apex737/Turret/reports/step8/v2_report.md

# Step8 v2 — Salford 밖 FPV 양성 추가 (CNN14 임베딩 + 로지스틱 회귀, 기체 하나씩 빼는 5-fold)

> `Tools/ml/train_v2.py`가 만든 파일. 새 FPV(DVIDS 영상 사람 라벨, Freesound 2개)는 학습 전용이고 시험 데이터는 v0과 같다.
> 문턱: 학습 데이터 안 교차검증에서 비드론 창 오탐 1%. 사건·클립 판정은 연속 3창 중 2창.

| 설정 | FPV 창 재현율 | FPV 창 AUC | FPV 대 곤충 AUC | Matrice 통과 AUC | Air 3(WS) 재현율 | 평균 창 AUC | 사건 (2-of-3) | 오탐/시간 | 장치 경로 재현율 (FPV / Mini3 / Air3) |
| --- | --- | --- | --- | --- | --- | --- | --- | --- | --- |
| v0 | 0.17 | 0.912 | 0.53 | 0.502 | 0.12 | 0.893 | 19/21 | 10.3 | 0.01 / 0.23 / 0.42 |
| v2 | 0.43 | 0.956 | 0.75 | 0.446 | 0.16 | 0.897 | 17/21 | 10.0 | 0.13 / 0.34 / 0.46 |
| v2m | 0.35 | 0.944 | 0.77 | 0.579 | 0.17 | 0.905 | 18/21 | 9.2 | 0.16 / 0.29 / 0.45 |
| v2m+N | 0.33 | 0.938 | 0.83 | 0.636 | 0.24 | 0.915 | 17/21 | 5.4 | 0.07 / 0.16 / 0.55 |
| v2m+dev | 0.34 | 0.948 | 0.78 | 0.567 | 0.16 | 0.902 | 17/21 | 7.3 | 0.13 / 0.19 / 0.21 |

**출처 사이 일반화:** DVIDS를 빼고 학습한 모델(fold 1 조건 + Freesound FPV)의 DVIDS FPV 창 재현율: dvids_110920176 0.19 (16창), dvids_111069165 0.54 (69창), dvids_24meu 0.46 (605창), dvids_26meu 0.00 (20창), dvids_predator26 0.48 (29창)

## v2 fold별

| fold | 시험 기체 | 창 AUC | 창 재현율 | 창 오탐률 | 사건 | 비드론 클립 오탐 | 장치 경로 재현율 |
| --- | --- | --- | --- | --- | --- | --- | --- |
| 1 | DJI FPV | 0.956 | 0.43 | 0.014 | 3/3 | 8/400 | 0.13 |
| 2 | Mini 3 Pro | 0.980 | 0.76 | 0.008 | 6/6 | 4/398 | 0.34 |
| 3 | Matrice 300 | 0.699 | 0.16 | 0.009 | 2/6 | 2/398 | - |
| 4 | Yuneec H520E | 0.990 | 0.84 | 0.010 | 4/4 | 6/398 | - |
| 5 | Air 3 (WS) | 0.862 | 0.16 | 0.009 | 2/2 | 6/397 | 0.46 |

v2 오탐이 많은 비드론 범주 (클립 수): insects 4, vacuum_cleaner 3, chirping_birds 2, washing_machine 2, airplane 2, chainsaw 2, door_wood_creaks 2, can_opening 1, rain 1, car_horn 1
