apex737/Turret/reports/step8/v1_report.md

# Step8 v1 — 증강 + 장치 잡음 음성 (CNN14 임베딩 + 로지스틱 회귀, 기체 하나씩 빼는 5-fold)

> `Tools/ml/train_v1.py`가 만든 파일. 입력 `embed_v0.py`(원본), `embed_v1.py`(증강·장치). 모델·fold·문턱 규칙은 v0과 같다.
> 문턱: 학습 데이터 안 교차검증에서 비드론 창 오탐 1%. 사건·클립 판정은 연속 3창 중 2창. 시험 fold는 증강하지 않는다.

## 설정별 요약

| 설정 | FPV 창 재현율 | Matrice 통과 AUC | Matrice 통과 재현율 | Air 3(WS) 재현율 | 평균 창 AUC | 사건 (2-of-3) | 오탐/시간 | 장치 경로 재현율 (FPV / Mini3 / Air3) |
| --- | --- | --- | --- | --- | --- | --- | --- | --- |
| v0 | 0.17 | 0.502 | 0.05 | 0.12 | 0.893 | 19/21 | 10.3 | 0.01 / 0.23 / 0.42 |
| +S | 0.19 | 0.492 | 0.05 | 0.12 | 0.893 | 19/21 | 10.7 | 0.01 / 0.19 / 0.37 |
| +D | 0.18 | 0.495 | 0.05 | 0.13 | 0.892 | 19/21 | 9.2 | 0.01 / 0.23 / 0.39 |
| +E | 0.19 | 0.490 | 0.05 | 0.12 | 0.888 | 19/21 | 11.5 | 0.01 / 0.25 / 0.40 |
| +N | 0.24 | 0.620 | 0.03 | 0.21 | 0.903 | 17/21 | 7.7 | 0.01 / 0.18 / 0.55 |
| +A | 0.06 | 0.673 | 0.06 | 0.15 | 0.886 | 17/21 | 5.0 | 0.00 / 0.12 / 0.41 |
| +dev | 0.18 | 0.473 | 0.05 | 0.11 | 0.887 | 18/21 | 8.8 | 0.01 / 0.17 / 0.29 |
| v1 | 0.07 | 0.639 | 0.03 | 0.03 | 0.893 | 17/21 | 1.9 | 0.00 / 0.02 / 0.04 |

**v1 판정 (개발용):** FPV 창 재현율 0.17 → 0.07 (목표 ≥ 0.5), Matrice 통과 AUC 0.502 → 0.639 (목표 ≥ 0.9), 오탐/시간 10.3 → 1.9 (v0 이하) → **미달**

## v1 fold별

| fold | 시험 기체 | 창 AUC | 창 재현율 | 창 오탐률 | 통과/호버 AUC | 사건 (2-of-3) | 비드론 클립 오탐 | 장치 경로 재현율 (창 수, 점수 중앙값) |
| --- | --- | --- | --- | --- | --- | --- | --- | --- |
| 1 | DJI FPV | 0.853 | 0.07 | 0.002 | 0.853 | 2/3 | 1/400 | 0.00 (576, 0.00) |
| 2 | Mini 3 Pro | 0.982 | 0.50 | 0.003 | 0.978 / 0.991 | 6/6 | 0/398 | 0.02 (192, 0.28) |
| 3 | Matrice 300 | 0.796 | 0.06 | 0.006 | 0.639 / 0.928 | 3/6 | 2/398 | - |
| 4 | Yuneec H520E | 0.984 | 0.60 | 0.003 | 0.983 / 0.986 | 4/4 | 0/398 | - |
| 5 | Air 3 (WS) | 0.848 | 0.03 | 0.005 | 0.848 | 2/2 | 2/397 | 0.04 (192, 0.80) |

v1 오탐이 많은 비드론 범주 (클립 수): siren 2, car_horn 1, airplane 1, clock_alarm 1

장치 경로 시험: speaker_10min (노트북 스피커 → 보드 MIC1), 재생 시작 6.75 s (포락선 상관 0.24). 장치 잡음 음성(같은 방·같은 보드)이 학습에 들어가므로 장치 경로 재현율은 낙관적일 수 있다.
