apex737/Turret/reports/step8/v0_report.md

# Step8 v0 — CNN14 임베딩 + 로지스틱 회귀 (공개 원음, 기체 하나씩 빼는 5-fold)

> `Tools/ml/train_v0.py`가 만든 파일. 입력 `Tools/ml/embed_v0.py` (장치와 같은 FIR·↓4 → 16 kHz → 1 s 창 → CNN14).
> 문턱: 학습 데이터 안 교차검증에서 비드론 창 오탐 1%. 사건·클립 판정은 연속 3창 중 2창.

| fold | 시험 기체 (학습에 없음) | 창 AUC | 무학습 AUC | 창 재현율 | 창 오탐률 | 사건 검출 (2-of-3) | 비드론 클립 오탐 |
| --- | --- | --- | --- | --- | --- | --- | --- |
| 1 | DJI FPV | 0.903 | 0.794 | 0.16 | 0.016 | 3/3 | 10/400 |
| 2 | Mini 3 Pro | 0.983 | 0.729 | 0.81 | 0.010 | 6/6 | 5/398 |
| 3 | Matrice 300 | 0.737 | 0.940 | 0.19 | 0.012 | 4/6 | 5/398 |
| 4 | Yuneec H520E | 0.991 | 0.830 | 0.85 | 0.009 | 4/4 | 4/398 |
| 5 | Air 3 (WS) | 0.840 | 0.737 | 0.13 | 0.006 | 2/2 | 3/397 |

**합계**: 드론 사건 19/21 검출, 비드론 클립 27/1991 오탐.

오탐이 많은 비드론 범주 (5 fold 합, 클립 수): airplane 5, insects 4, vacuum_cleaner 3, chainsaw 3, car_horn 2, chirping_birds 2, can_opening 1, snoring 1, washing_machine 1, rain 1, siren 1, wind 1
