apex737/Turret/Plots/CubeMonitor1.png

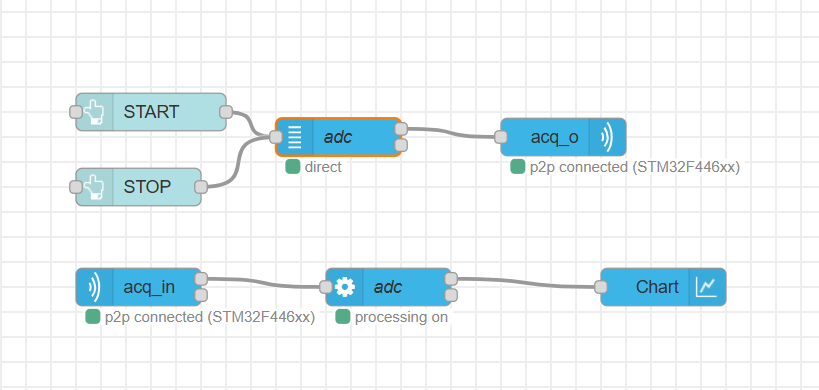
Plots/CubeMonitor1.png
