apex737/Turret/Plots/instruments_v1/preview.png

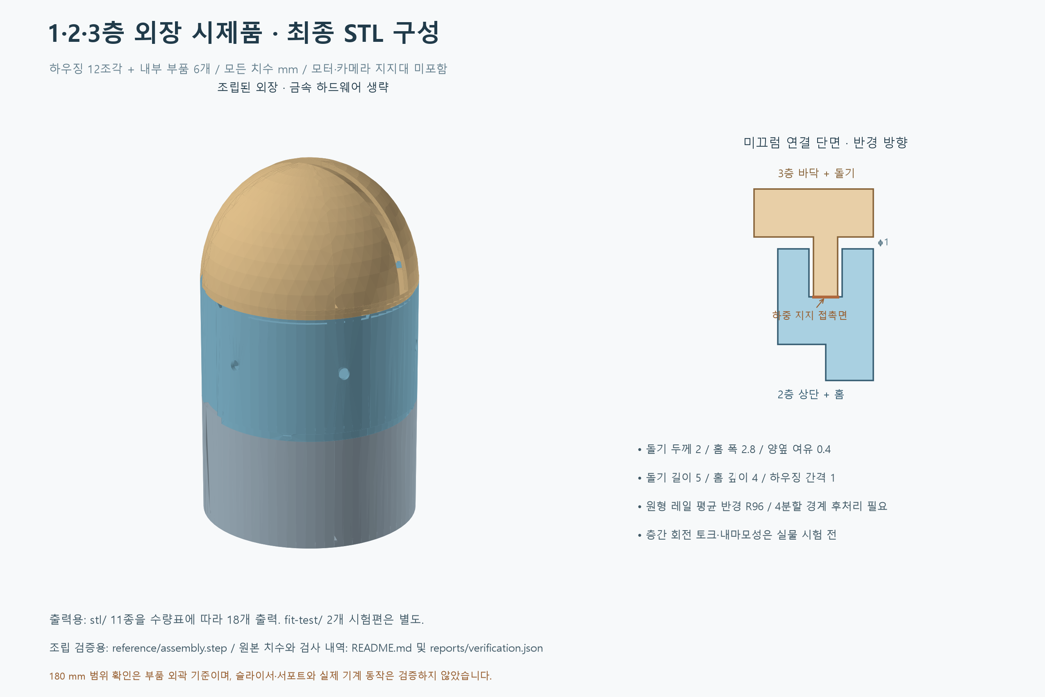
Plots/instruments_v1/preview.png
