apex737/Turret/hardware/enclosure_v1/reference/tier1_assembly.step

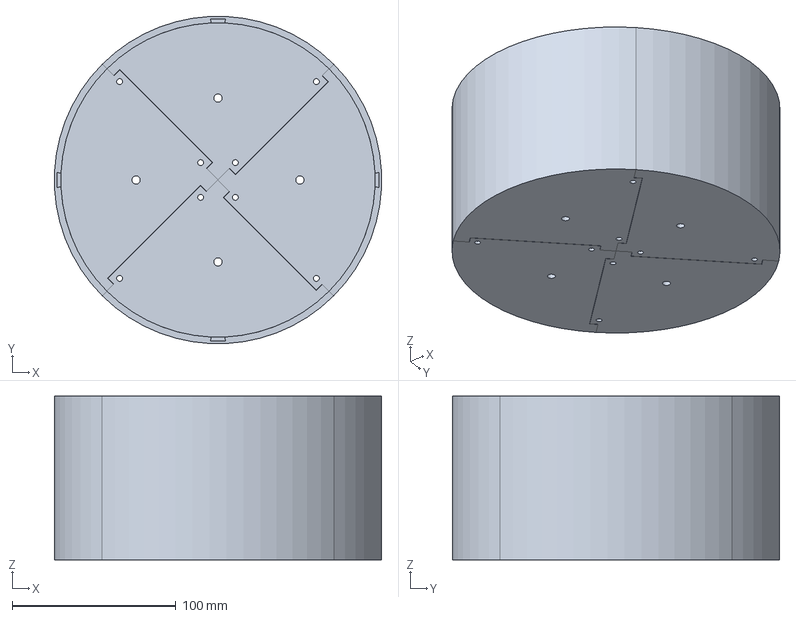
[picture p3: CAD file, 2026-10-22]
hardware/enclosure_v1/reference/tier1_assembly.step
199.7 x 199.7 x 100.0 mm
