apex737/Turret/hardware/enclosure_v1/reference/tier2_assembly.step

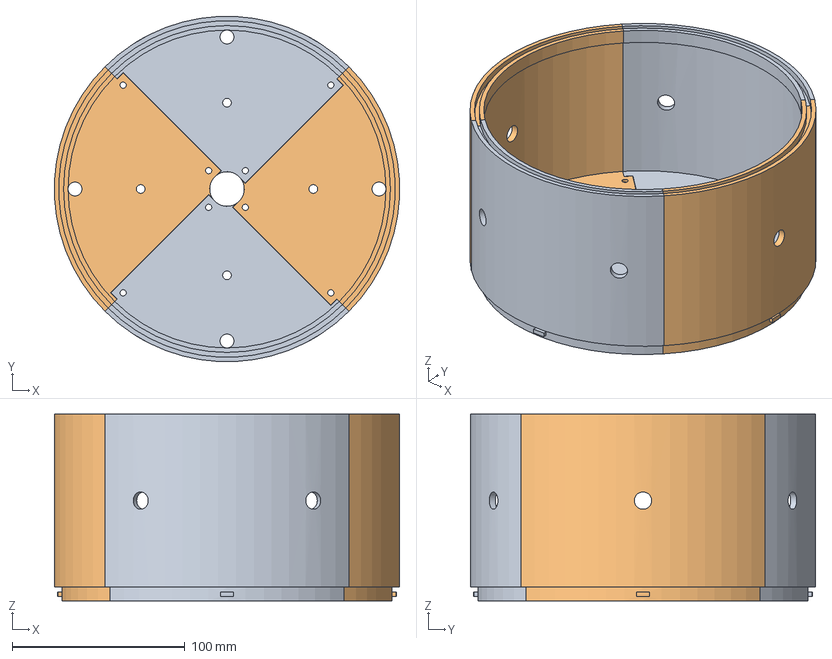
[picture p4: CAD file, 2026-10-22]
hardware/enclosure_v1/reference/tier2_assembly.step
200.0 x 199.7 x 108.0 mm
