apex737/Turret/hardware/enclosure_v1/step/battery_02_threaded_moving_slide.step

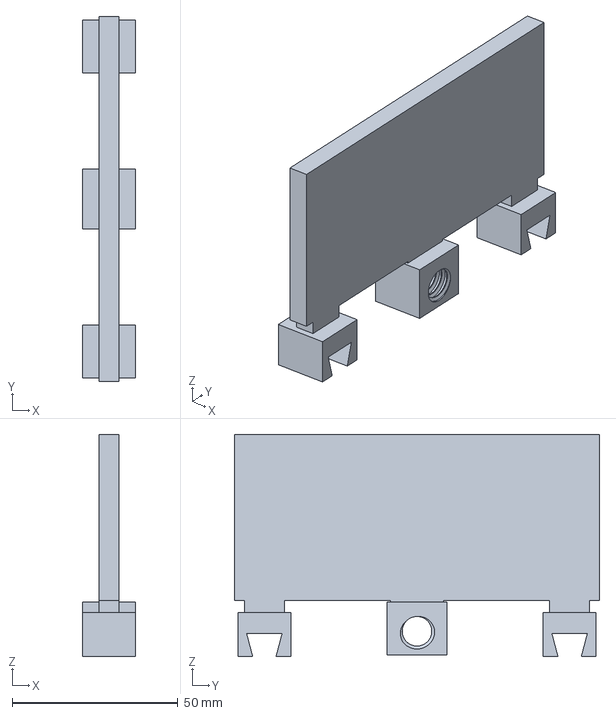
[picture p5: CAD file, 2026-10-22]
hardware/enclosure_v1/step/battery_02_threaded_moving_slide.step
16.0 x 110.0 x 67.0 mm
