apex737/Turret/hardware/enclosure_v1/stl/battery_04_opposite_corner.stl

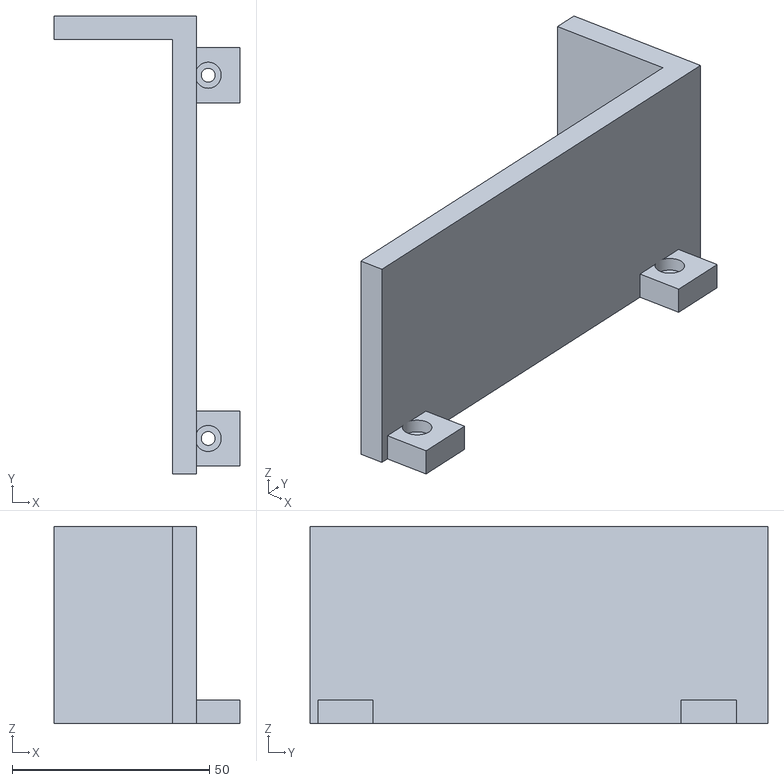
[picture p6: CAD file, 2026-10-22]
hardware/enclosure_v1/stl/battery_04_opposite_corner.stl
47.0 x 116.0 x 50.0
