apex737/Turret/Plots/instruments_v1/stl/2_2.stl

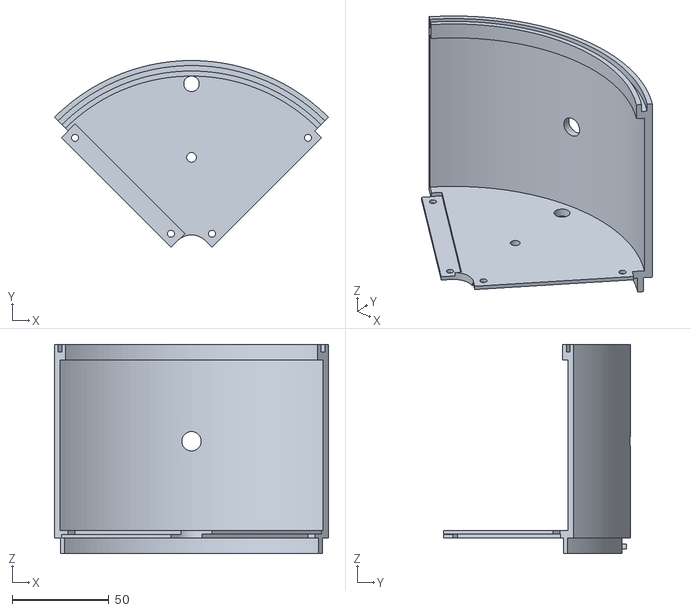
[picture p7: CAD file, 2026-10-22]
Plots/instruments_v1/stl/2_2.stl
141.4 x 96.5 x 108.0
