apex737/Turret/hardware/enclosure_v1/stl/battery_05_shaft_retaining_clip.stl

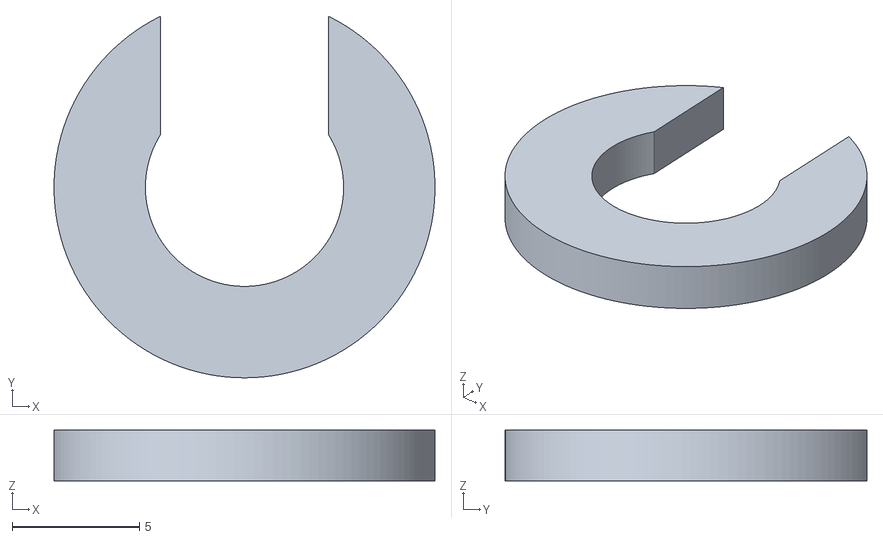
[picture p8: CAD file, 2026-10-22]
hardware/enclosure_v1/stl/battery_05_shaft_retaining_clip.stl
15.0 x 14.2 x 2.00
