apex737/Turret/Plots/instruments_v1/step/battery_03_insert_slider_base.step

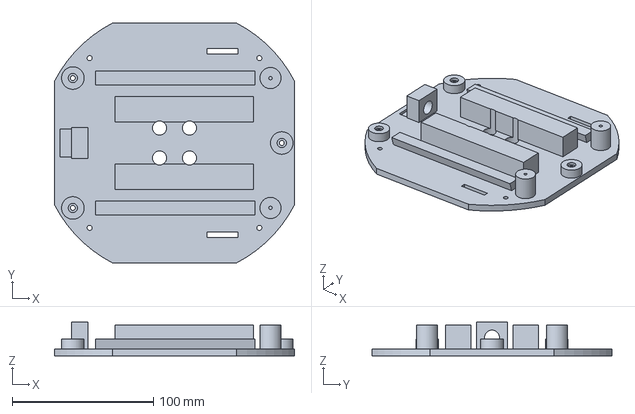
[picture p9: CAD file, 2026-10-22]
Plots/instruments_v1/step/battery_03_insert_slider_base.step
170.0 x 170.0 x 24.0 mm
