apex737/Turret/Plots/instruments_v1/step/battery_01_adjustment_screw.step

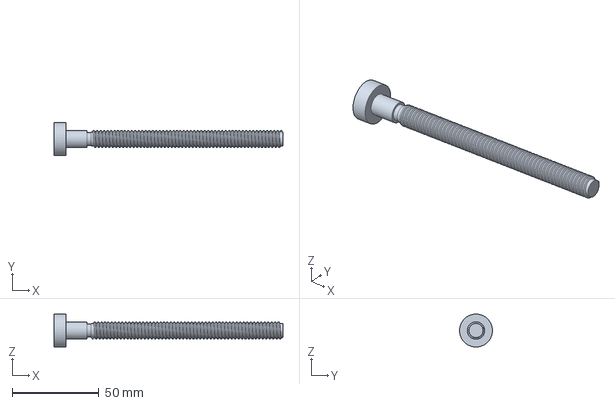
[picture p10: CAD file, 2026-10-22]
Plots/instruments_v1/step/battery_01_adjustment_screw.step
132.0 x 19.0 x 19.0 mm
