apex737/Turret/(list of files, cad)

Other CAD files:
hardware/enclosure_v1/step/2_1.step
Plots/instruments_v1/step/battery_05_shaft_retaining_clip.step
Plots/instruments_v1/stl/battery_02_threaded_moving_slide.stl
hardware/enclosure_v1/step/2_2.step
Plots/instruments_v1/stl/battery_01_adjustment_screw.stl
hardware/enclosure_v1/stl/2_1.stl
