apex737/Turret/reports/step5/playback.md

# 재생 경로 측정 — 스피커 → MAX4466 (2026-10-16)

> 녹음: BURST 모드, `Tools/dumps/step5/` (git 제외). 비교: `Tools/audio/playback_check.py`. 그림: `playback_*.png`

## 조건

| 항목 | 값 |
| --- | --- |
| 스피커 | 노트북 내장, 볼륨 최대, Windows 오디오 향상 끔 |
| 거리 | 배열에서 약 1 m, 같은 높이 |
| 배열 | 정삼각형 7 cm (`config/geometry.json`), ch1·ch2·ch3 = MIC1·MIC2·MIC3 (문질러서 확인) |
| 마이크 전원 | Nucleo 3.3V → 220 Ω → 레일, 레일–GND 100 µF (f_c 7.2 Hz) |
| ch3 | 예비 모듈로 교체 (기존 모듈은 쇼트 이력, 고역 잡음 큼) |
| 게인 | pink 기준 200–5000 Hz에서 세 채널 ±1.1 dB (`pink_adj`) |

## 결과

| 항목 | 값 |
| --- | --- |
| 재생 대역 (−10 dB) | 약 270 Hz부터 (노트북 스피커 저역 한계, 필터 달기 전 pink/quiet로 측정) |
| 스피커 왜곡 | 550 Hz 단일음의 2배 고조파가 음량과 상관없이 약 −36 dBc (스피커 자체 특성) |
| 압축 | 파일 −12 dBFS 이상에서 녹음 음량이 덜 커짐 (최대 단계에서 6 dB 대신 2 dB) |
| 클리핑 | 모든 기록용 녹음에서 0 |

**원본 대 장치, 연속으로 쓸 만한 고조파 수** (빗살 SNR 6 dB 이상, ch1)

| 원음 | 원본 | 장치 | 잃은 것 |
| --- | --- | --- | --- |
| FPV ev1 | 4 | 3 | 4배 고조파 (약 2.1 kHz, SNR 7.7 → 3.9 dB) |
| FPV ev2 | 4 | 3 | 〃 |
| FPV ev3 | 4 | 3 | 〃 |
| Mini 3 Pro 호버 | 8 | 10 | — |
| Air 3 | 9 | 9 | 기본음 SNR 7.2 → 3.8 dB (스피커 저역) |

## 판정

- **FPV 고조파가 장치에서 3개 남는다 → 재생음을 Step6·7 장치 데이터로 쓴다** (이전 Step5 문서 5-4 기준).
- f_use = 5 kHz, ↓4는 그대로 둔다. 잃은 4배 고조파(약 2.1 kHz)는 5 kHz 대역 안이다. 대역이 좁아서가 아니라 1 m 재생 SNR 때문에 잃은 것이다.
- 재생음으로 할 수 없는 것:
  - 270 Hz 아래 (대형 기체의 기본음)
  - 실제 FPV의 음량·거리 감쇠
  - 야외 바람 소리

  이 셋은 실기나 야외 녹음 전까지 미검증으로 남긴다.
