apex737/Turret/reports/step9a/eval_rule.md

# Step9A 결합 평가 — `rule`

> `Tools/fusion/eval_9a.py`가 만든 파일. 수치만 적는다 (판정은 Steps/Step9A.md).
> 분류 = 정답 타임라인, 방향 = Step7 12방향 녹음 (D1, 공통 회전 +11.4°). 분류 도착 지연 0.3 s, 방향 0.02 s. 고장 채점의 허용 관측 나이 1.0 s, 해제 허용 2.0 s.

| 녹음 | 공동 성공률 F0 (드론 시점 수) | 드론 없음 시점의 drone 출력 (시점 수) | F2 비드론 구간 넣은 뒤 공동 성공률 | F4 분류 1.5 s 늦음 공동 성공률 |
|---|---|---|---|---|
| doa_az000 | 0.90 (279) | 0 (69) | 0.89 | 0.00 |
| doa_az120 | 0.87 (277) | 0 (70) | 0.85 | 0.00 |
| doa_az150 | 0.88 (277) | 0 (72) | 0.87 | 0.00 |
| doa_az180 | 0.90 (272) | 0 (73) | 0.89 | 0.00 |
| doa_az210 | 0.89 (273) | 0 (72) | 0.88 | 0.00 |
| doa_az240 | 0.90 (275) | 0 (71) | 0.89 | 0.00 |
| doa_az270 | 0.89 (277) | 0 (70) | 0.88 | 0.00 |
| doa_az30 | 0.89 (283) | 0 (70) | 0.88 | 0.00 |
| doa_az300 | 0.90 (286) | 0 (70) | 0.90 | 0.00 |
| doa_az330 | 0.90 (276) | 0 (70) | 0.89 | 0.00 |
| doa_az60 | 0.90 (283) | 0 (70) | 0.89 | 0.00 |
| doa_az90 | 0.88 (276) | 0 (70) | 0.86 | 0.00 |
| **최소 / 중앙** | 0.87 / 0.90 | 0 | | |

## 고장 주입 — 잘못된 결합 (위반 시점 / 채점 시점)

| 고장 | 위반 | 내용 |
|---|---|---|
| F1 PC 멈춤 3 s | 0 / 96 | 멈춘 뒤 1.0 s 지나서도 drone |
| F2 비드론 구간 | 0 / 864 | 비드론 시작 2.0 s 뒤에도 drone |
| F3 방향 무효 2 s | 0 / 48 | 무효 시작 1.0 s 뒤에도 drone |
| F5 방향 바뀜 (az000 → az120) | 0 / 236 | 바뀐 뒤 1.0 s 지나서 옛 방위 (새 정답과 10° 초과) |
