apex737/Turret/Plots/build_analyze.png

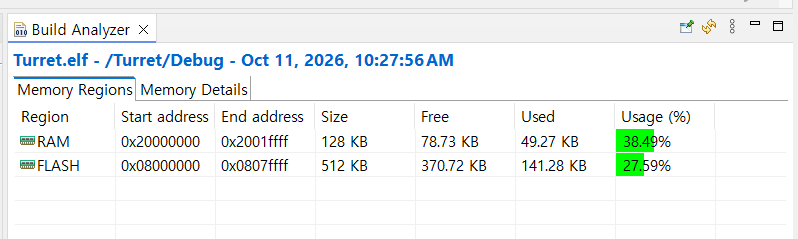
Plots/build_analyze.png
