apex737/Turret/reports/step5/fir_response.png

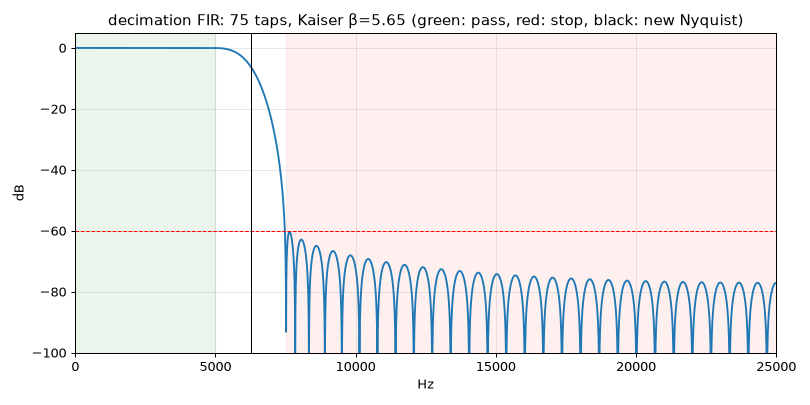
reports/step5/fir_response.png
