apex737/Turret/reports/step5/playback_fpv_ev2.png

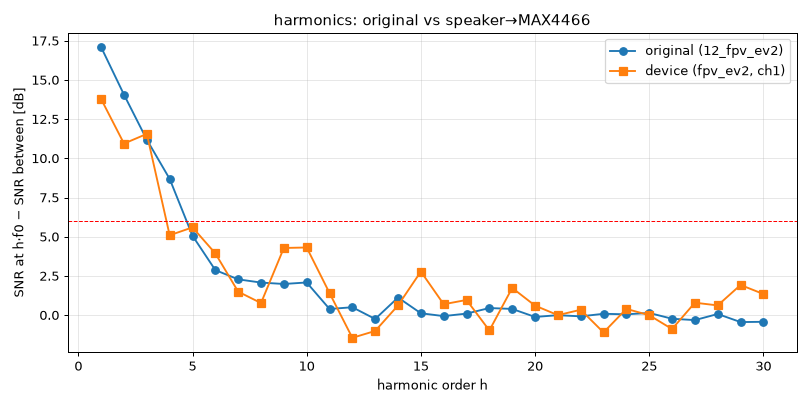
reports/step5/playback_fpv_ev2.png
