apex737/Turret/reports/step5/playback_fpv_ev3.png

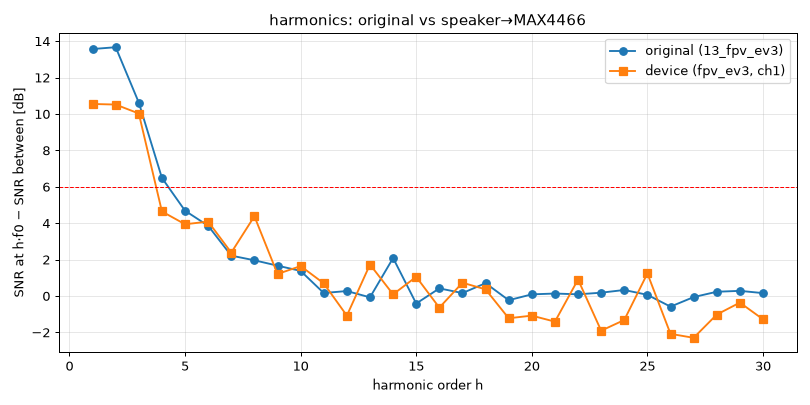
reports/step5/playback_fpv_ev3.png
