apex737/Turret/reports/step5/playback_mini3pro.png

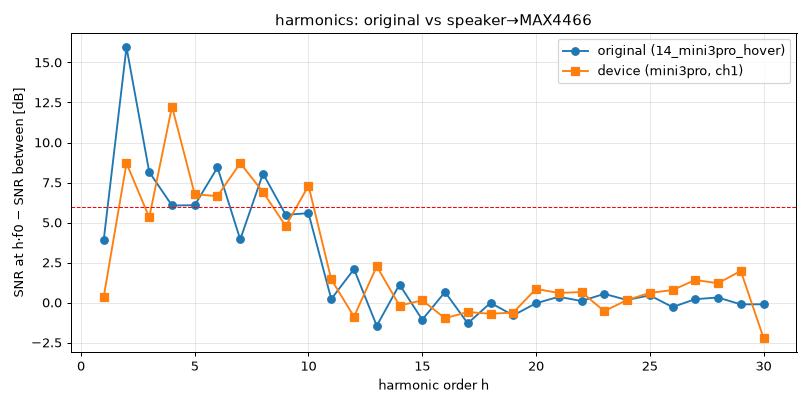
reports/step5/playback_mini3pro.png
