apex737/Turret/reports/step5/Salford_DJI_FPV_flyover.png

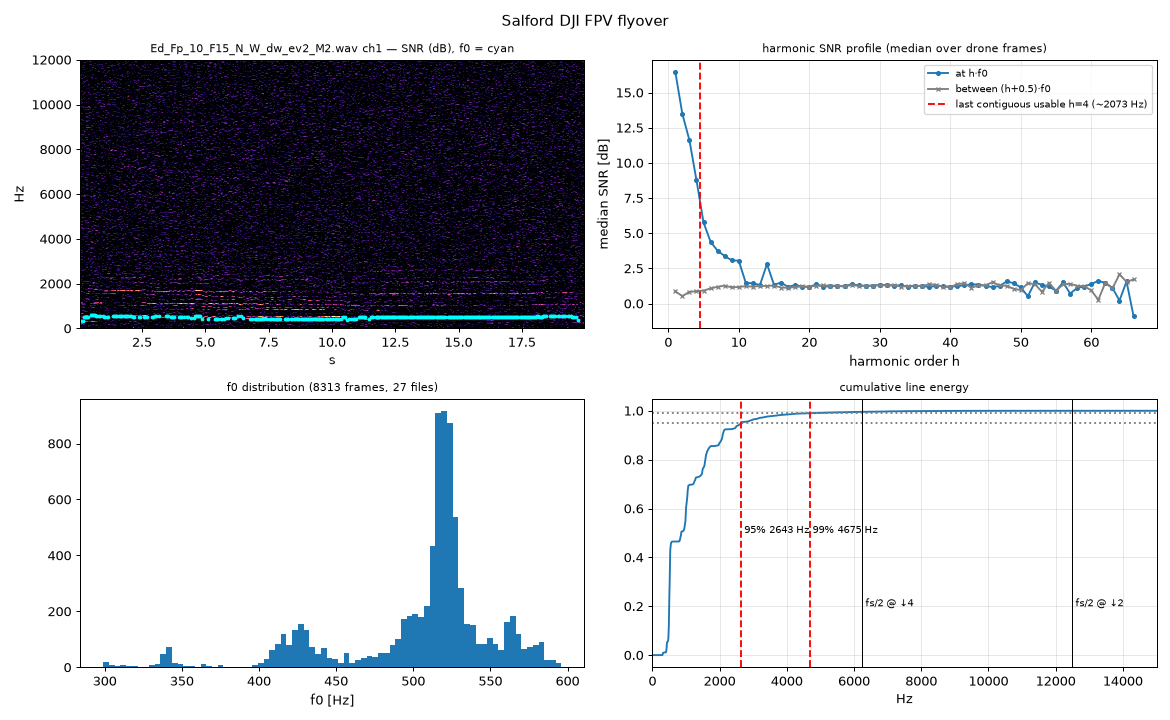
reports/step5/Salford_DJI_FPV_flyover.png
