apex737/Turret/reports/step5/Salford_Matrice_300_flyover.png

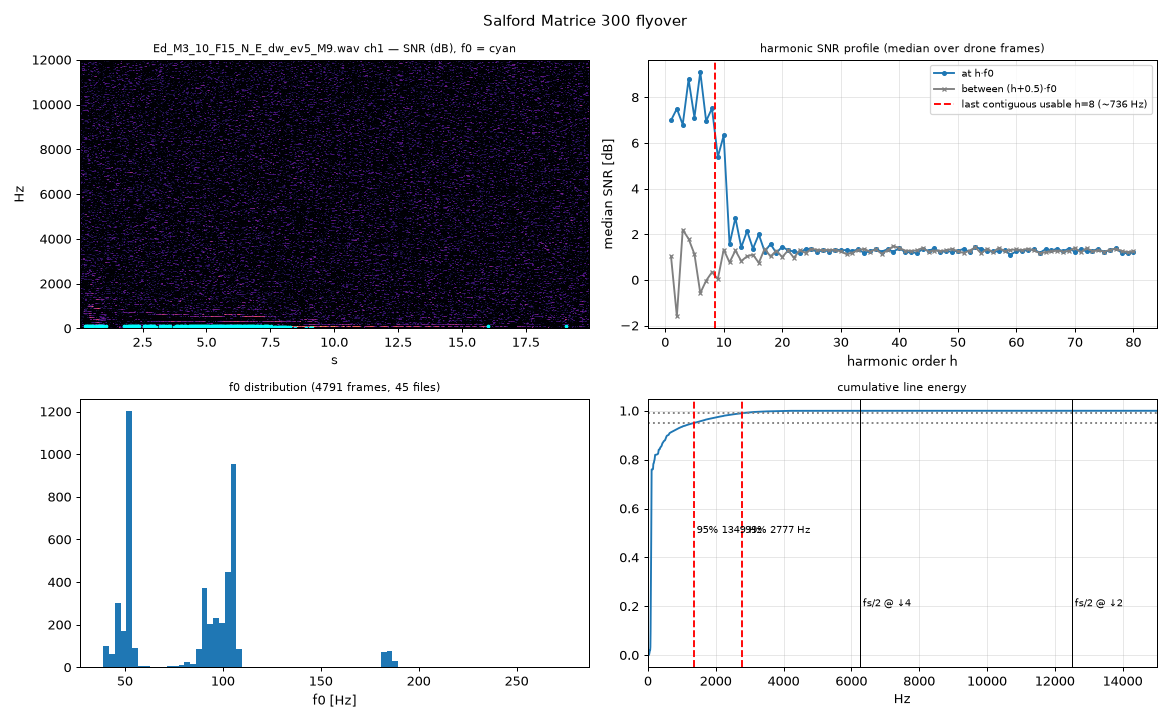
reports/step5/Salford_Matrice_300_flyover.png
