apex737/Turret/reports/step5/Salford_Matrice_300_hover.png

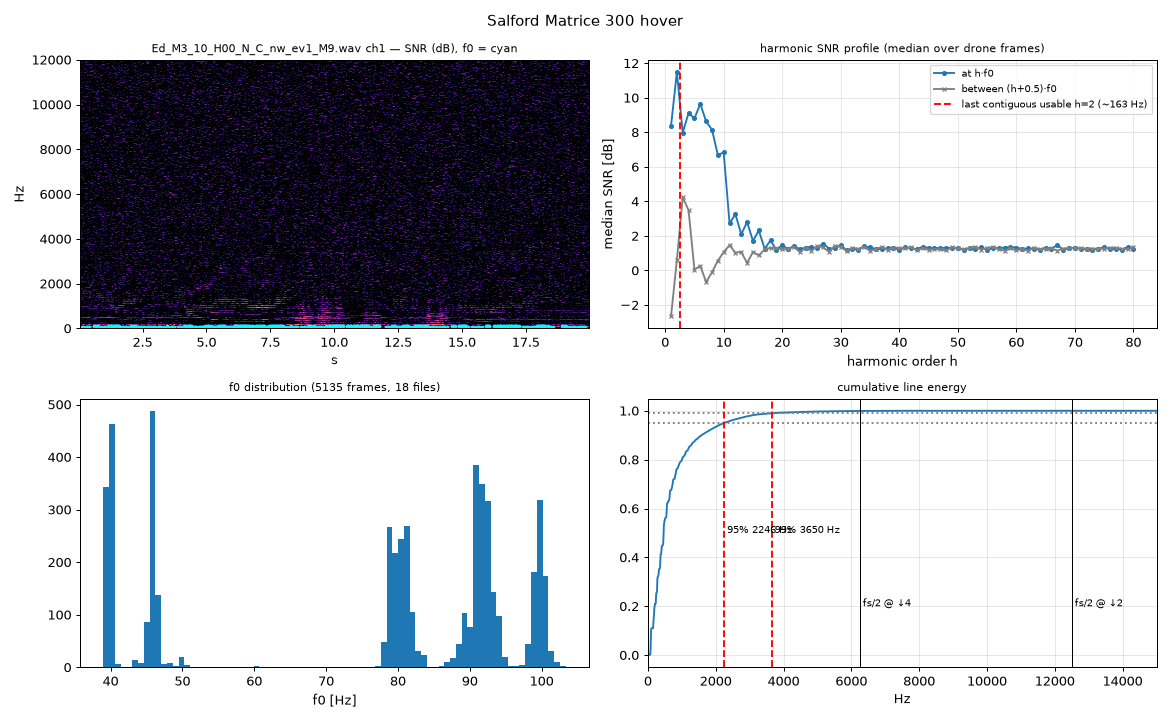
reports/step5/Salford_Matrice_300_hover.png
