apex737/Turret/reports/step5/Salford_Mini_3_Pro_hover.png

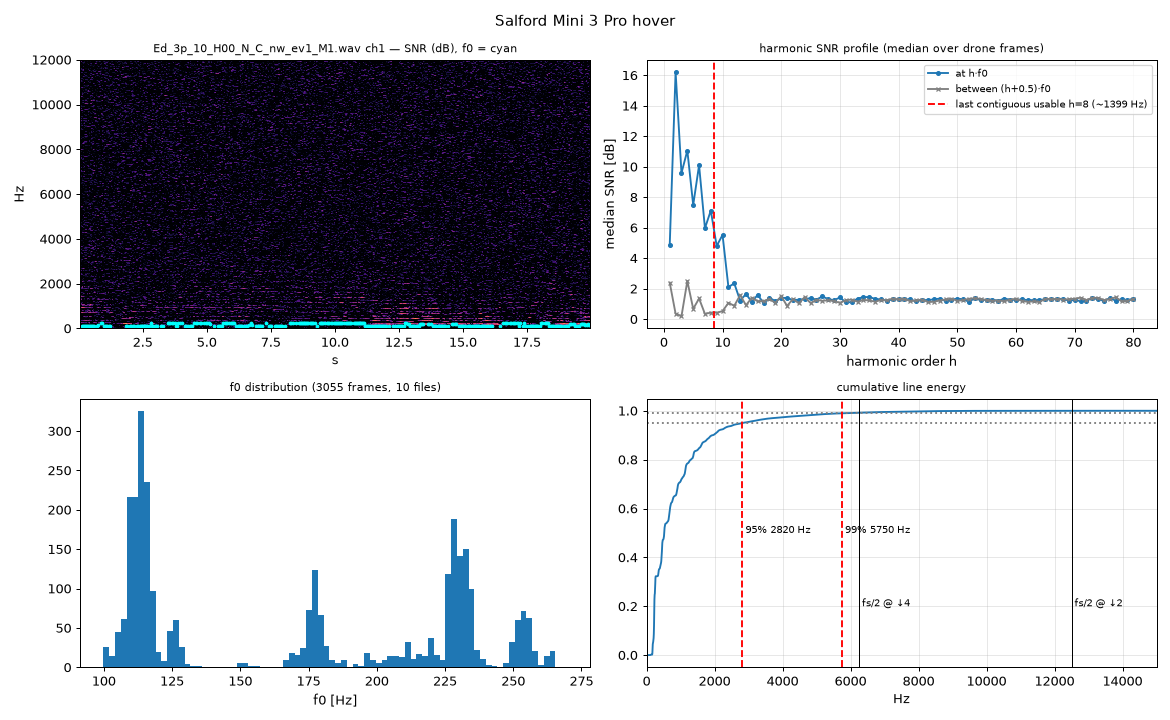
reports/step5/Salford_Mini_3_Pro_hover.png
