apex737/Turret/reports/step5/Salford_Yuneec_H520E_flyover.png

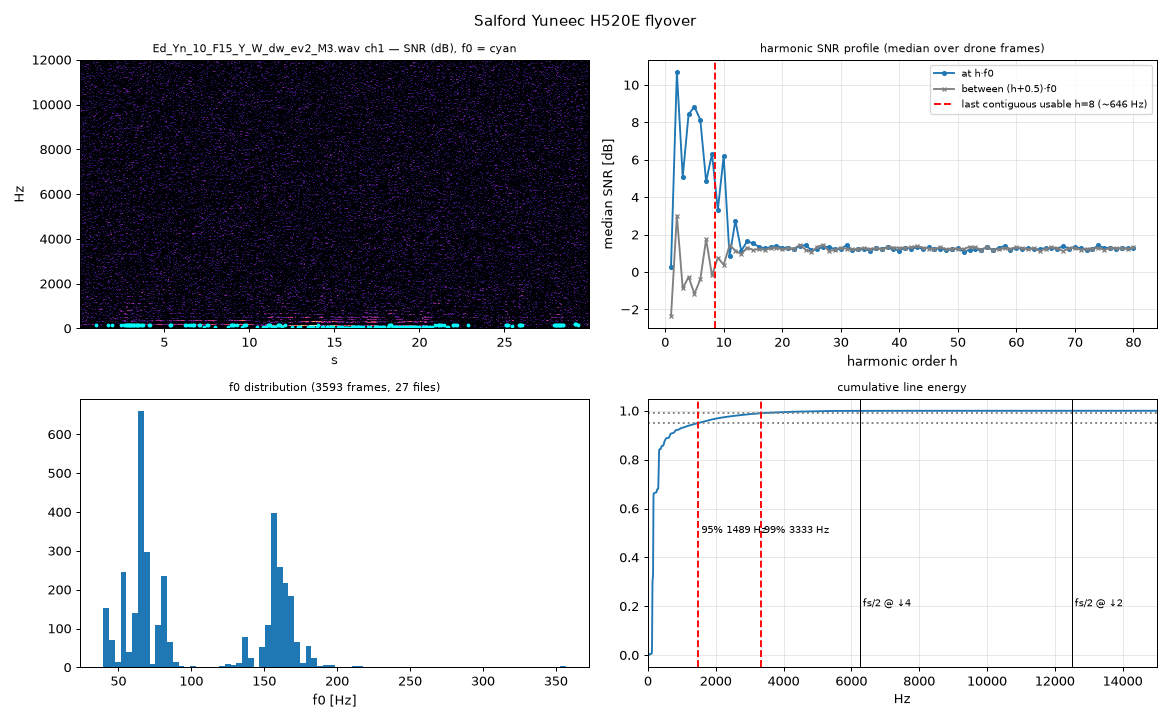
reports/step5/Salford_Yuneec_H520E_flyover.png
