apex737/Turret/Plots/deg30_rotate_test.jpg

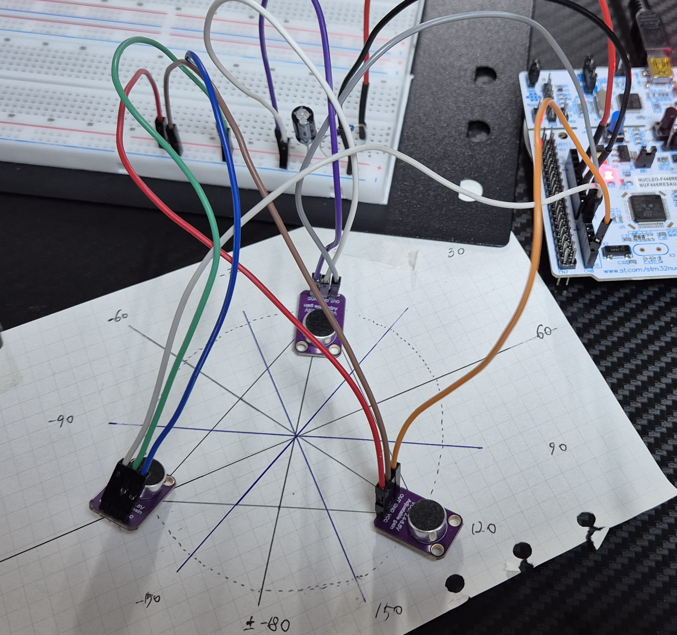
Plots/deg30_rotate_test.jpg
