apex737/Turret/Core/app/inc/fir_coeffs.h

#ifndef FIR_COEFFS_H
#define FIR_COEFFS_H
/* Tools/preproc/fir_design.py 가 만든 파일. 직접 고치지 말 것.
 * 50 kHz → 12.5 kHz (M = 4), Kaiser beta 5.653, 통과 5000 Hz / 저지 7500 Hz / 60 dB
 * 통과 리플 0.016 dB, 저지 최대 -60.4 dB, 군지연 37 샘플 @ 50 kHz
 * CMSIS 순서(시간 역순)로 저장. 대칭 계수라 순서는 결과에 영향 없음 */
#define FIR_DECIM_M     4u
#define FIR_NUM_TAPS    75u
#define FIR_GROUP_DELAY 37u   /* 50 kHz 샘플 */

static const float fir_coeffs[FIR_NUM_TAPS] = {
    -1.239866251e-04f,  2.927059248e-19f,  2.666497603e-04f,  5.127551849e-04f,
     4.776863207e-04f, -8.510825650e-19f, -7.747346535e-04f, -1.360024908e-03f,
    -1.177875907e-03f,  1.729133700e-18f,  1.710087410e-03f,  2.874754602e-03f,
     2.398068318e-03f, -2.920184963e-18f, -3.273703158e-03f, -5.365336314e-03f,
    -4.376608878e-03f,  4.354734107e-18f,  5.758579355e-03f,  9.299242869e-03f,
     7.491478231e-03f, -5.902923392e-18f, -9.681769647e-03f, -1.555298362e-02f,
    -1.249876991e-02f,  7.391331920e-18f,  1.623397693e-02f,  2.630594745e-02f,
     2.143969759e-02f, -8.631480799e-18f, -2.930530719e-02f, -4.955936596e-02f,
    -4.293629900e-02f,  9.454234341e-18f,  7.374851406e-02f,  1.579184830e-01f,
     2.245891839e-01f,  2.499233335e-01f,  2.245891839e-01f,  1.579184830e-01f,
     7.374851406e-02f,  9.454234341e-18f, -4.293629900e-02f, -4.955936596e-02f,
    -2.930530719e-02f, -8.631480799e-18f,  2.143969759e-02f,  2.630594745e-02f,
     1.623397693e-02f,  7.391331920e-18f, -1.249876991e-02f, -1.555298362e-02f,
    -9.681769647e-03f, -5.902923392e-18f,  7.491478231e-03f,  9.299242869e-03f,
     5.758579355e-03f,  4.354734107e-18f, -4.376608878e-03f, -5.365336314e-03f,
    -3.273703158e-03f, -2.920184963e-18f,  2.398068318e-03f,  2.874754602e-03f,
     1.710087410e-03f,  1.729133700e-18f, -1.177875907e-03f, -1.360024908e-03f,
    -7.747346535e-04f, -8.510825650e-19f,  4.776863207e-04f,  5.127551849e-04f,
     2.666497603e-04f,  2.927059248e-19f, -1.239866251e-04f
};

#endif
