apex737/Turret/(commit log)

2026-10-10 step3: GCC-PHAT 방향 추정 (Python 프로토타입 + MCU 이식)
    - Tools/gcc_phat.py: GCC-PHAT, 2차 보간, 최소제곱 각도 변환, selftest/sweep
    - Tools/doa_live.py: 실시간 나침반, 세션 저장, MCU 결과와 자동 비교
    - Core/app tdoa.c/h: 같은 계산을 CMSIS-DSP로 구현 (PC 결과와 일치 확인)
    - dump: 결과 패킷(type 0x02)과 VALID 플래그 추가
    - capture: 캡처 콜백, CAPTURE_SEND_RAW 로 원파형+결과 / 결과 전용 모드 선택
    - MCU 신뢰 판정 (peak >= 0.5, 0.3 <= norm <= 1.2)
    - Drivers/CMSIS/DSP: CMSIS-DSP 1.10.0 헤더와 필요한 소스 15개
    - .cproject: DSP include 경로, -Ofast
    - Steps: Step3 문서 추가, Step1/Step2 갱신
    - .git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
2026-10-11 docs: Step3 기준선 baseline-v1 정의, IDE 개인 설정 gitignore
2026-10-15 Step5 연속 수음·전처리, Step6·8 학습 v0, Tools 폴더 정리
    - 펌웨어: ADC 프레임 번호·overrun 재시작, CMSIS FIR ↓4 전처리(preproc),
    PCM v3 스트림(stream), PC/MCU 검증 모드(verify), APP_MODE 4종
    - Tools: board/doa/preproc/audio/ml 폴더로 분류, 스트림 수신·검증·
    프레임 동기 간섭 측정 도구, PC 기준 전처리와 호스트 빌드 비교
    - 학습 v0: 공개 원음 데이터셋·split, CNN14 임베딩 + 로지스틱 회귀 평가
    - 문서: Step5 연속수음, Step6 데이터 규칙, Step8 v0 결과, 마이크 전원 RC 필터 기록
    - .gitignore: wav·pth·pt 제외
2026-10-16 Step5 통과, HSE 클럭, Step7 방향 추정 PC 구현
    - Step5 보드 시험 4개 통과 (VERIFY 1 LSB, STREAM 10분 ×3 유실 0)
    - 마이크 전원 RC 필터와 ch3 모듈 교체 결과 기록
    - 클럭 HSI → HSE BYPASS 8 MHz (샘플레이트 +1.76% → +0.005%)
    - stream_capture: 수신 스레드와 1 MB 버퍼로 PC 쪽 유실 수정
    - Step7: doa_stream / eval_doa_synth, 배경 빼기로 합성 SNR +10 dB 유효율 62% → 91%
    - 재생 파일: 10분 드론 재생목록, 방향 시험용 왼쪽 채널 파일
    Next: 0~360도 45도 간격으로 지속음 인식여부 확인 및 PC 검증
2026-10-22 코드 주석 보강: 핸들·패킷 필드·전처리 변수 설명
2026-10-22 문서 구조 개편: problem·decisions·Steps·docs·learning 분리
    - problem.md(G·P·I 초안), decisions.md(4문 레코드, D1-1~D8-6, DO-1·2) 신설
    - Steps/StepN.md를 frontmatter 형식(80줄 이내)으로 재작성, 실험 경과는 Steps/logs/
    - 프로토콜·펌웨어·실행 절차를 docs/로, 학습 기록을 learning/으로
    - Plots/ → reports/·learning/notes/·hardware/
    - Tools/flow/gen_flow.py로 flow.html 생성, migration.md에 이전 절 대응 기록
2026-10-22 Step 문서를 질문과 답 두괄식으로, 교재 수준 확인 절차 추가
    - Steps/StepN.md: "## 질문"을 "## 질문과 답"(Q + 한 줄 결론과 핵심 숫자)으로
    - README: Step 템플릿·규칙 8(교재는 learning/background.html, 수준 확인 후)·규칙 10 보완
    - learning/GUIDE.md v1.2: 교재·시각 자료를 만들 때 수준 근거(질의 또는 시험 결과) 절차
    - Step8 v1 진행 기준 문단을 logs/Step8.md로 옮겨 80줄 유지
    - 사용자가 편집한 표 정렬·문구(problem.md, profile.md, Step2·3) 포함
2026-10-22 학습 방식 v2.0: 퀴즈 기록·맞춤 교재 폐기, 틀린 개념만 concepts.html로
    - learning/quiz.md, quiz_keys.md, background.html 삭제 (기록은 fdf6311에 남음)
    - GUIDE.md v2.0: 수준 판단은 4절 트리거에서만, 5절 형식의 서술형 문항,
    채점은 대화 안에서, △·❌·⚠ 개념만 concepts.html에 키워드·간략 설명·쓰인 Step으로 추가,
    이해 표시·제거는 사람이 UI로, AI는 교재를 만들지 않음
    - README 구조·규칙 8을 새 방식에 맞춤
2026-10-22 의존 개념 절과 explain 지표 제거
    - Steps/StepN.md: "## 의존 개념" 절, status.explain 삭제
    - README 템플릿, GUIDE.md 단계 상태 보고, flow 템플릿(설명 막대) 정리
    - 개념이 어느 Step에 걸렸는지는 concepts.html의 Step 거르기로 확인
2026-10-22 docs를 그림 중심 HTML로: interfaces.html(경계 약속), firmware.html(내부 구조)
    - docs/interfaces.html: 형식(32비트 워드 바이트 배치도)·의미(플래그 비트, PCM 변환, 시간축)·
    규칙(수신 파서 절차, 끊김 표시), 대역폭, 같이 고칠 짝
    - docs/firmware.html: 모듈 지도, 데이터 흐름, 클럭 트리, DMA 핑퐁(adc.c 동작 시뮬레이션),
    송신 큐(조작 가능), doa 창 누적, RAM·CPU 막대, 모드, 코드 블록, 빌드·CubeMX
    - docs/protocol.md, firmware.md 삭제, Step·decisions 링크를 새 절로
    - gen_flow.py: Windows 콘솔 인코딩 자체 처리, 패키지 없을 때 안내. README 5절·run.md에 누가 언제 실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
2026-10-22 migration.md 제거와 참조 정리
    - migration.md 삭제 (기록은 git 이력에 남음)
    - README 구조도에서 제거, "이전 판 N절"의 뜻을 README에 한 줄로
    - Step4 남은 일 문장에서 migration.md 링크 제거
2026-10-22 Step8 v5 장치 경로 평가, Step9A 결합 규칙, 결정 트리 decision.html
    - Step8 v5: devpath_A·B 녹음 정렬·학습 평가. 장치 FPV 0.07 (기준 > 0.12 미달), 장치 창 오탐 v3m 6.8% → v5 4.2% (기준 ≤ 1% 미달), v5p로 지름길 확인. 다음 결정 D8-7 대기
    - Step9A: Tools/fusion (eval_9a 평가 틀·고장 주입, combine 결합 규칙). 정답 타임라인 분류로 공동 성공률 0.87 ~ 0.90, 잘못된 결합 0 (D9A-1)
    - decisions.md → decision.html (버린 길 흐리게, 누를 때만 이유)
    - problem.md 파츠 등급 정의, md 물결표 띄우기, 관측 나이 → 결과 경과 시간
    - APP_MODE를 STREAM으로 (장치 경로 녹음)
    Co-Authored-B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
